jp112sdl/HM_Wasserzaehler/(threads)

Thread 1 (2020-05-25):

Fehlermeldung beim Flashen des D1 mini

Wolf6660, 2020-05-25:
Hi,

bin dabei das Project nachzubauen. Leider bekomme ich folgende Fehlermeldung wenn ich den D1 mini Flashen will:

```
Arduino: 1.8.12 (Mac OS X), Board: "LOLIN(WEMOS) D1 R2 & mini, 80 MHz, Flash, Legacy (new can return nullptr), All SSL ciphers (most compatible), 4MB (FS:2MB OTA:~1019KB), v2 Lower Memory, Disabled, None, All Flash Contents, 921600"

In file included from /Users/wolf/Library/Arduino15/packages/esp8266/hardware/esp8266/2.7.1/tools/sdk/libc/xtensa-lx106-elf/include/sys/stdio.h:6:0,
                 from /Users/wolf/Library/Arduino15/packages/esp8266/hardware/esp8266/2.7.1/tools/sdk/libc/xtensa-lx106-elf/include/stdio.h:63,
                 from /Users/wolf/Library/Arduino15/packages/esp8266/hardware/esp8266/2.7.1/cores/esp8266/Arduino.h:32,
                 from sketch/Wasserzaehler_ESP8266.ino.cpp:1:
/Users/wolf/Library/Arduino15/packages/esp8266/hardware/esp8266/2.7.1/tools/sdk/libc/xtensa-lx106-elf/include/sys/pgmspace.h:25:130: error: 'const char HTTP_HEAD []' redeclared as different kind of symbol
   #define PROGMEM __attribute__((section( "\".irom.text." __FILE__ "." __STRINGIZE(__LINE__) "."  __STRINGIZE(__COUNTER__) "\"")))
                                                                                                                                  ^
/Users/wolf/Documents/Arduino/libraries/WiFiManager/WiFiManager.h:25:24: note: in expansion of macro 'PROGMEM'
 const char HTTP_HEAD[] PROGMEM            = "<!DOCTYPE html><html lang=\"en\"><head><meta name=\"viewport\" content=\"width=device-width, initial-scale=1, user-scalable=no\"/><title>{v}</title>";
                        ^
In file included from /Users/wolf/Documents/Arduino/libraries/WiFiManager/WiFiManager.h:17:0,
                 from /Users/wolf/Downloads/Wasser/HM_Wasserzaehler/Wasserzaehler_ESP8266/Wasserzaehler_ESP8266.ino:3:
/Users/wolf/Library/Arduino15/packages/esp8266/hardware/esp8266/2.7.1/libraries/ESP8266WebServer/src/ESP8266WebServer.h:34:39: error: previous declaration of 'HTTPMethod HTTP_HEAD'
 enum HTTPMethod { HTTP_ANY, HTTP_GET, HTTP_HEAD, HTTP_POST, HTTP_PUT, HTTP_PATCH, HTTP_DELETE, HTTP_OPTIONS };
                                       ^
/Users/wolf/Downloads/Wasser/HM_Wasserzaehler/Wasserzaehler_ESP8266/Wasserzaehler_ESP8266.ino: In function 'void setup()':
/Users/wolf/Downloads/Wasser/HM_Wasserzaehler/Wasserzaehler_ESP8266/Wasserzaehler_ESP8266.ino:93:8: warning: 'SPIFFS' is deprecated (declared at /Users/wolf/Library/Arduino15/packages/esp8266/hardware/esp8266/2.7.1/cores/esp8266/FS.h:269): SPIFFS has been deprecated. Please consider moving to LittleFS or other filesystems. [-Wdeprecated-declarations]
   if (!SPIFFS.begin()) {
        ^
/Users/wolf/Downloads/Wasser/HM_Wasserzaehler/Wasserzaehler_ESP8266/Wasserzaehler_ESP8266.ino: In function 'void loop()':
/Users/wolf/Downloads/Wasser/HM_Wasserzaehler/Wasserzaehler_ESP8266/Wasserzaehler_ESP8266.ino:198:55: warning: comparison between signed and unsigned integer expressions [-Wsign-compare]
     for (int i = 10; i > ((String)ZaehlerWert).length(); i--)
                                                       ^
/Users/wolf/Downloads/Wasser/HM_Wasserzaehler/Wasserzaehler_ESP8266/CCUhandling.ino: In function 'bool setStateCCUCUxD(String, String)':
/Users/wolf/Downloads/Wasser/HM_Wasserzaehler/Wasserzaehler_ESP8266/CCUhandling.ino:7:19: warning: 'bool HTTPClient::begin(String)' is deprecated (declared at /Users/wolf/Library/Arduino15/packages/esp8266/hardware/esp8266/2.7.1/libraries/ESP8266HTTPClient/src/ESP8266HTTPClient.h:172) [-Wdeprecated-declarations]
     http.begin(url);
                   ^
/Users/wolf/Downloads/Wasser/HM_Wasserzaehler/Wasserzaehler_ESP8266/ConfigFileHandling.ino: In function 'bool loadSysConfig()':
/Users/wolf/Downloads/Wasser/HM_Wasserzaehler/Wasserzaehler_ESP8266/ConfigFileHandling.ino:2:21: warning: 'SPIFFS' is deprecated (declared at /Users/wolf/Library/Arduino15/packages/esp8266/hardware/esp8266/2.7.1/cores/esp8266/FS.h:269): SPIFFS has been deprecated. Please consider moving to LittleFS or other filesystems. [-Wdeprecated-declarations]
   File configFile = SPIFFS.open("/" + configFilename, "r");
                     ^
/Users/wolf/Downloads/Wasser/HM_Wasserzaehler/Wasserzaehler_ESP8266/ConfigFileHandling.ino: In function 'bool saveSysConfig()':
/Users/wolf/Downloads/Wasser/HM_Wasserzaehler/Wasserzaehler_ESP8266/ConfigFileHandling.ino:52:21: warning: 'SPIFFS' is deprecated (declared at /Users/wolf/Library/Arduino15/packages/esp8266/hardware/esp8266/2.7.1/cores/esp8266/FS.h:269): SPIFFS has been deprecated. Please consider moving to LittleFS or other filesystems. [-Wdeprecated-declarations]
   File configFile = SPIFFS.open("/" + configFilename, "w");
                     ^
/Users/wolf/Downloads/Wasser/HM_Wasserzaehler/Wasserzaehler_ESP8266/Debug.ino: At global scope:
/Users/wolf/Downloads/Wasser/HM_Wasserzaehler/Wasserzaehler_ESP8266/Debug.ino:4:6: warning: unused parameter 'Tag' [-Wunused-parameter]
 void DEBUG(String DebugMessage, String Tag, byte Severity) {
      ^
/Users/wolf/Downloads/Wasser/HM_Wasserzaehler/Wasserzaehler_ESP8266/Debug.ino:4:6: warning: unused parameter 'Severity' [-Wunused-parameter]
/Users/wolf/Downloads/Wasser/HM_Wasserzaehler/Wasserzaehler_ESP8266/OTA.ino:11:69: warning: unused parameter 'progress' [-Wunused-parameter]
   ArduinoOTA.onProgress([](unsigned int progress, unsigned int total) {
                                                                     ^
/Users/wolf/Downloads/Wasser/HM_Wasserzaehler/Wasserzaehler_ESP8266/OTA.ino:11:69: warning: unused parameter 'total' [-Wunused-parameter]
/Users/wolf/Downloads/Wasser/HM_Wasserzaehler/Wasserzaehler_ESP8266/OTA.ino:11:69: warning: unused parameter 'progress' [-Wunused-parameter]
/Users/wolf/Downloads/Wasser/HM_Wasserzaehler/Wasserzaehler_ESP8266/OTA.ino:11:69: warning: unused parameter 'total' [-Wunused-parameter]
/Users/wolf/Downloads/Wasser/HM_Wasserzaehler/Wasserzaehler_ESP8266/WifiManager.ino: In function 'bool doWifiConnect()':
/Users/wolf/Downloads/Wasser/HM_Wasserzaehler/Wasserzaehler_ESP8266/WifiManager.ino:6:35: warning: comparison between signed and unsigned integer expressions [-Wsign-compare]
   for (int i = 0; i < _psk.length(); i++) {
                                   ^
/Users/wolf/Downloads/Wasser/HM_Wasserzaehler/Wasserzaehler_ESP8266/WifiManager.ino:93:7: warning: 'SPIFFS' is deprecated (declared at /Users/wolf/Library/Arduino15/packages/esp8266/hardware/esp8266/2.7.1/cores/esp8266/FS.h:269): SPIFFS has been deprecated. Please consider moving to LittleFS or other filesystems. [-Wdeprecated-declarations]
       SPIFFS.end();
       ^
/Users/wolf/Downloads/Wasser/HM_Wasserzaehler/Wasserzaehler_ESP8266/WifiManager.ino: At global scope:
/Users/wolf/Downloads/Wasser/HM_Wasserzaehler/Wasserzaehler_ESP8266/WifiManager.ino:101:6: warning: unused parameter 'myWiFiManager' [-Wunused-parameter]
 void configModeCallback (WiFiManager *myWiFiManager) {
      ^
/Users/wolf/Downloads/Wasser/HM_Wasserzaehler/Wasserzaehler_ESP8266/CCUhandling.ino: In function 'bool setStateCCUCUxD(String, String)':
/Users/wolf/Downloads/Wasser/HM_Wasserzaehler/Wasserzaehler_ESP8266/CCUhandling.ino:27:1: warning: control reaches end of non-void function [-Wreturn-type]
 }
 ^
exit status 1
Fehler beim Kompilieren für das Board LOLIN(WEMOS) D1 R2 & mini.

```

Was mache ich falsch? Kannst du mir einen Tipp geben?

Danke

jp112sdl, 2020-05-25:
Hi,
im Laufe der Zeit hat sich wohl einiges an den Libs etc geändert.
Ich mache an dem Projekt nichts mehr.
Am besten, du flashst dir die vorkompilierte .bin Datei
https://github.com/jp112sdl/HM_Wasserzaehler/raw/master/Wasserzaehler_ESP8266/Wasserzaehler_ESP8266.ino.d1_mini.bin

Oder versuchst mit Google&Co den PROGMEM Fehler zu fixen

Wolf6660, 2020-05-25:
OK danke für deine Antwort. Habe die bin in den Ordner kopiert und nun bekomme ich diese Meldung. Vielleicht sagt dir das etwas:

Arduino: 1.8.12 (Mac OS X), Board: "LOLIN(WEMOS) D1 R2 & mini, 80 MHz, Flash, Legacy (new can return nullptr), All SSL ciphers (most compatible), 4MB (FS:2MB OTA:~1019KB), v2 Lower Memory, Disabled, None, Only Sketch, 921600"

In file included from /Users/wolf/Library/Arduino15/packages/esp8266/hardware/esp8266/2.7.1/tools/sdk/libc/xtensa-lx106-elf/include/sys/stdio.h:6:0,
                 from /Users/wolf/Library/Arduino15/packages/esp8266/hardware/esp8266/2.7.1/tools/sdk/libc/xtensa-lx106-elf/include/stdio.h:63,
                 from /Users/wolf/Library/Arduino15/packages/esp8266/hardware/esp8266/2.7.1/cores/esp8266/Arduino.h:32,
                 from sketch/Wasserzaehler_ESP8266.ino.cpp:1:
/Users/wolf/Library/Arduino15/packages/esp8266/hardware/esp8266/2.7.1/tools/sdk/libc/xtensa-lx106-elf/include/sys/pgmspace.h:25:130: error: 'const char HTTP_HEAD []' redeclared as different kind of symbol
   #define PROGMEM __attribute__((section( "\".irom.text." __FILE__ "." __STRINGIZE(__LINE__) "."  __STRINGIZE(__COUNTER__) "\"")))
                                                                                                                                  ^
/Users/wolf/Documents/Arduino/libraries/WiFiManager/WiFiManager.h:25:24: note: in expansion of macro 'PROGMEM'
 const char HTTP_HEAD[] PROGMEM            = "<!DOCTYPE html><html lang=\"en\"><head><meta name=\"viewport\" content=\"width=device-width, initial-scale=1, user-scalable=no\"/><title>{v}</title>";
                        ^
In file included from /Users/wolf/Documents/Arduino/libraries/WiFiManager/WiFiManager.h:17:0,
                 from /Users/wolf/Downloads/Wasser/HM_Wasserzaehler/Wasserzaehler_ESP8266/Wasserzaehler_ESP8266.ino:3:
/Users/wolf/Library/Arduino15/packages/esp8266/hardware/esp8266/2.7.1/libraries/ESP8266WebServer/src/ESP8266WebServer.h:34:39: error: previous declaration of 'HTTPMethod HTTP_HEAD'
 enum HTTPMethod { HTTP_ANY, HTTP_GET, HTTP_HEAD, HTTP_POST, HTTP_PUT, HTTP_PATCH, HTTP_DELETE, HTTP_OPTIONS };
                                       ^
exit status 1
Fehler beim Kompilieren für das Board LOLIN(WEMOS) D1 R2 & mini.

Dieser Bericht wäre detaillierter, wenn die Option
"Ausführliche Ausgabe während der Kompilierung"
in Datei -> Voreinstellungen aktiviert wäre.

jp112sdl, 2020-05-25:
> Habe die bin in den Ordner kopiert

Nein, du sollst die .bin direkt auf den ESP flashen.
z.B. mit dem Espressif Flash Download Tool
https://www.espressif.com/en/support/download/other-tools

Wolf6660, 2020-05-25:
Hi, sorry für die vielen dummen Fragen aber das ist nicht gerade mein Spezialgebiet.

So das konnte ich Flashen aber wie bekomme ich nun deine Skripte auf den D1 oder benötige ich diese nicht?
Hat der D1 kein Web-Interface?
Wenn ich diesen einrichte und dann die IP eingebe kommt nichts?

jp112sdl, 2020-05-25:
> Wenn ich diesen einrichte und dann die IP eingebe kommt nichts?

Das ist korrekt.
Es gibt nur den AP-Modus zur Konfiguration von WLAN, CCU-IP und Systemvariable.
https://github.com/jp112sdl/HM_Wasserzaehler#inbetriebnahme

Anschließend sendet der ESP den Zählerstand zyklisch an die CCU

Closed 2020-06-16.
