jp112sdl/HM_Wasserzaehler/Wasserzaehler_ESP8266/Debug.ino

void DEBUG(String DebugMessage) {
  DEBUG(DebugMessage, "DummyTag",_slInformational);
}
void DEBUG(String DebugMessage, String Tag, byte Severity) {
#ifdef UDPDEBUG
  if (UDPClient.Ready) {
    UDPClient.UDP.beginPacket(SYSLOGIP, SYSLOGPORT);
    byte severity = 8 + Severity;
    UDPClient.UDP.write(String("<" + String(severity) + ">" + DEVICENAME + " " + Tag + " " + DebugMessage).c_str());
    UDPClient.UDP.endPacket();
  }
#endif

#ifdef SERIALDEBUG
  Serial.println(DebugMessage);
#endif
}
